rubienr/coax-relay-switch-shortwave/README.md

Shortwave Coax Switch for Antennas
__________________________________
* Very simple schema that switches up to four antenna relays.
* Needs poer just for switching process, remains without during radio operation.
* Up to 1.5KW with GUNNER 18V bistabile 25A AC relay.

Example
_______
The system contains of 4 PCBs:

* The input switch box:
  * 1x switch-matrix (ensures only one relay being active)
  * 1x relais-with-led-indicator (keeps the state, has LED indicator)

* The antenna switch box:
  * 1x switch-matrix (ensures only one relay being active)
  * 1x relais-with-led-indicator (keeps the state, LEDs optional)

Schema and PCB
______________
* Schemas
  * [switch-matrix](https://github.com/rubienr/coax-relay-switch-shortwave/blob/master/docs/switch-matrix-schema.pdf)
  * [relais-with-led-indicator](https://github.com/rubienr/coax-relay-switch-shortwave/blob/master/docs/led-indicator-schema.pdf)
* PCBs
  * [switch-matrix](https://github.com/rubienr/coax-relay-switch-shortwave/blob/master/docs/switch-matrix-pcb.pdf)
  * [relais-with-led-indicator](https://github.com/rubienr/coax-relay-switch-shortwave/blob/master/docs/relais-pcb.pdf)

Pictures
________
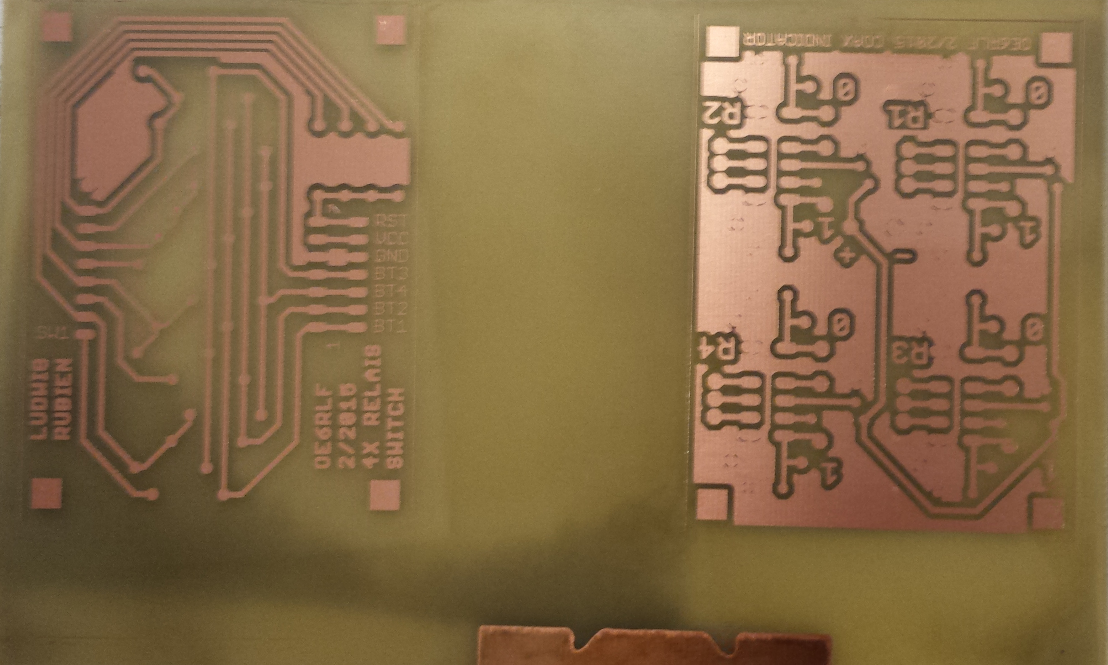
[picture p1: docs/pics/pcb-example.jpg]
bare PCB

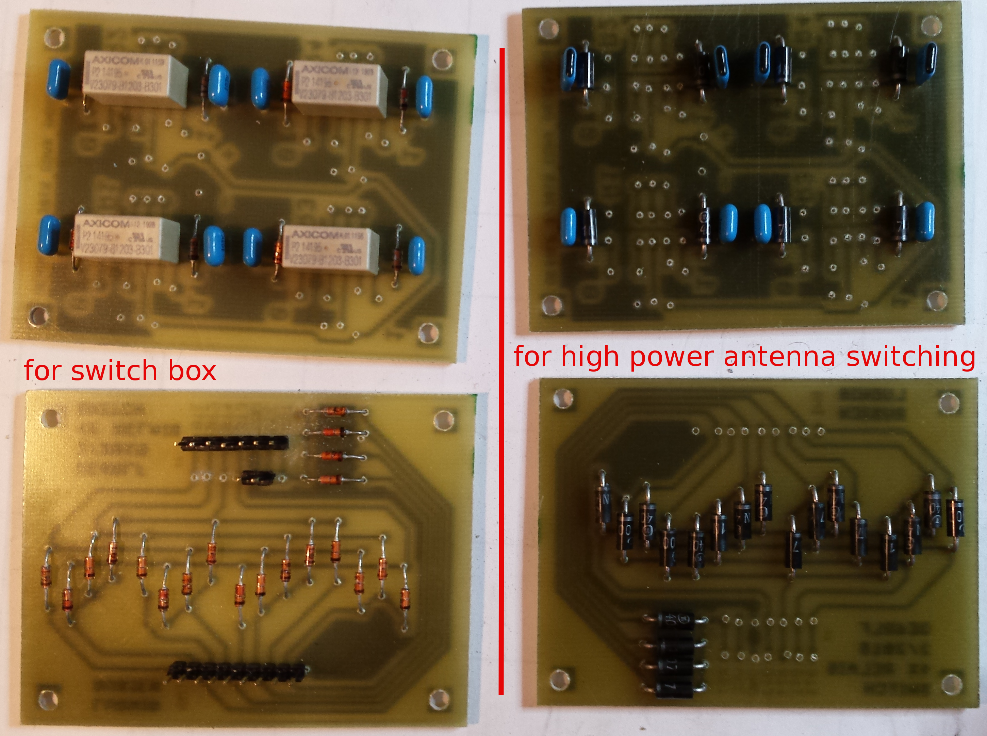
[picture p2: docs/pics/pcb-example-2.jpg]
assembled PCBs

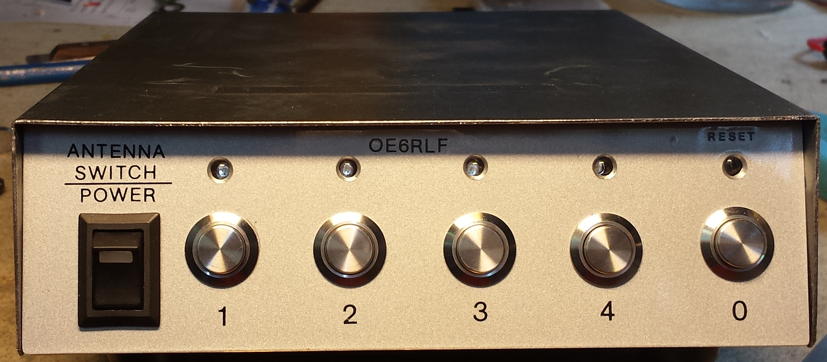
[picture p3: docs/pics/switch-box.jpg]
switch box/pannel

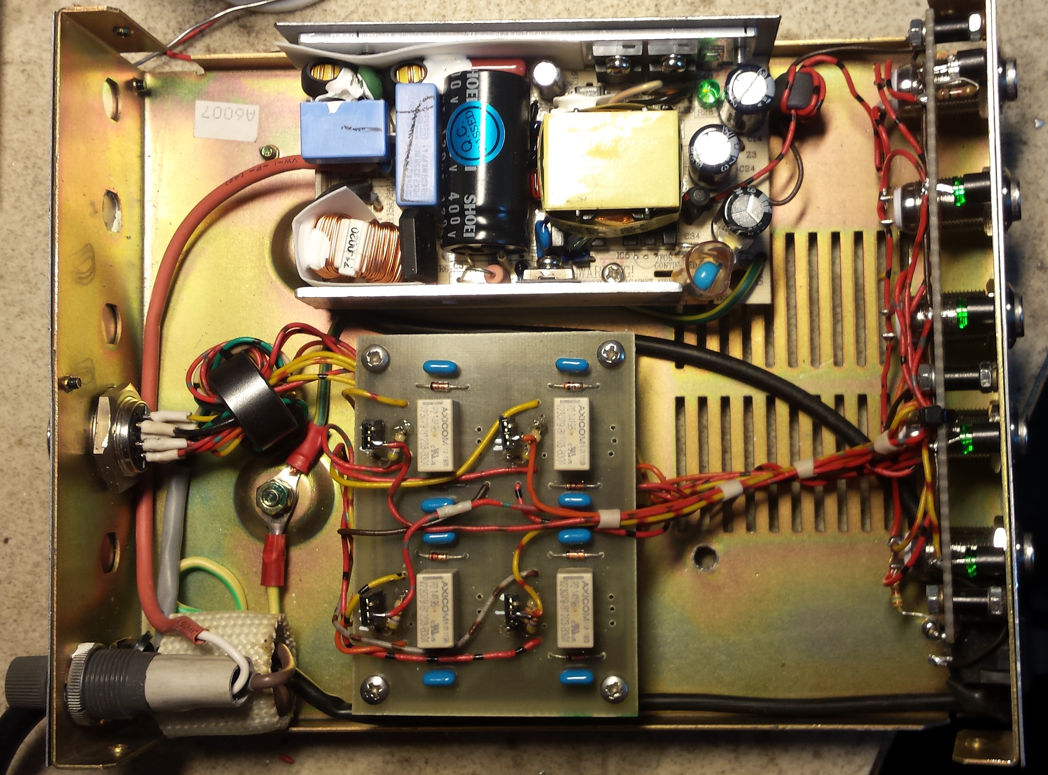
[picture p4: docs/pics/switch-box-interna.jpg]
switch box/pannel interna

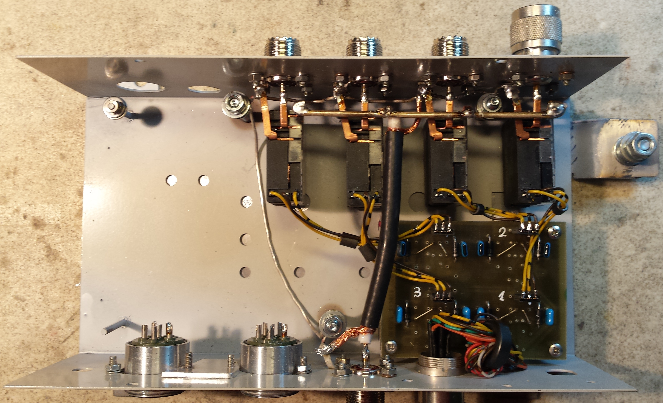
[picture p5: docs/pics/switch-matrix-with-relais-stacked-for-antenna-output.jpg]
antenna swtich box with stacked PCBs and high power relais
