rubienr/coax-relay-switch-shortwave/docs/led-indicator-schema.pdf

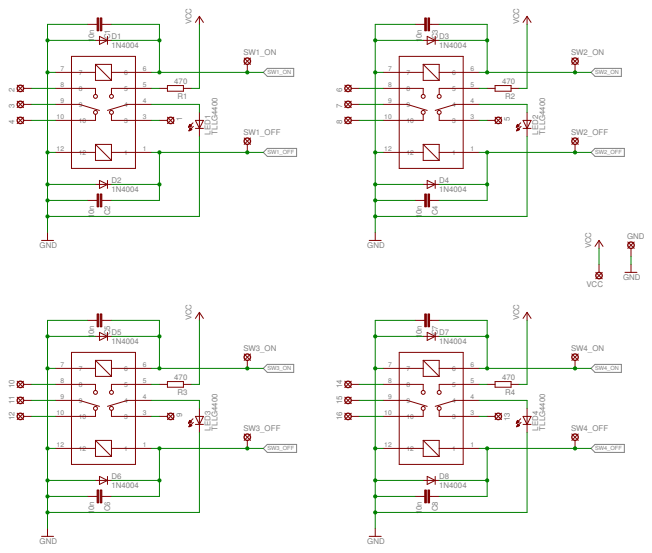
[picture p6: page 1]

TLLG4400 VCC 470 10n 1N4004 1N4004 10n GND GND VCC TLLG4400 VCC 470 10n 1N4004 1N4004 10n GND TLLG4400 VCC 470 10n 1N4004 1N4004 10n GND TLLG4400 VCC 470 10n 1N4004 1N4004 10n GND LED1 1 1 3 3 4 4 5 5 6 6 7 7 8 8 9 9 10 10 12 12 R1 C1D1 D2 C2 1 2 3 4 SW1_ON SW1_OFF VCC GND LED2 1 1 3 3 4 4 5 5 6 6 7 7 8 8 9 9 10 10 12 12 R2 C3D3 D4 C4 5 6 7 8 SW2_ON SW2_OFF LED3 1 1 3 3 4 4 5 5 6 6 7 7 8 8 9 9 10 10 12 12 R3 C5D5 D6 C6 9 10 11 12 SW3_ON SW3_OFF LED4 1 1 3 3 4 4 5 5 6 6 7 7 8 8 9 9 10 10 12 12 R4 C7D7 D8 C8 13 14 15 16 SW4_ON SW4_OFF SW1_ON SW1_OFF SW2_ON SW2_OFF SW3_ON SW3_OFF SW4_ON SW4_OFF
