rubienr/coax-relay-switch-shortwave/docs/relais-pcb.pdf

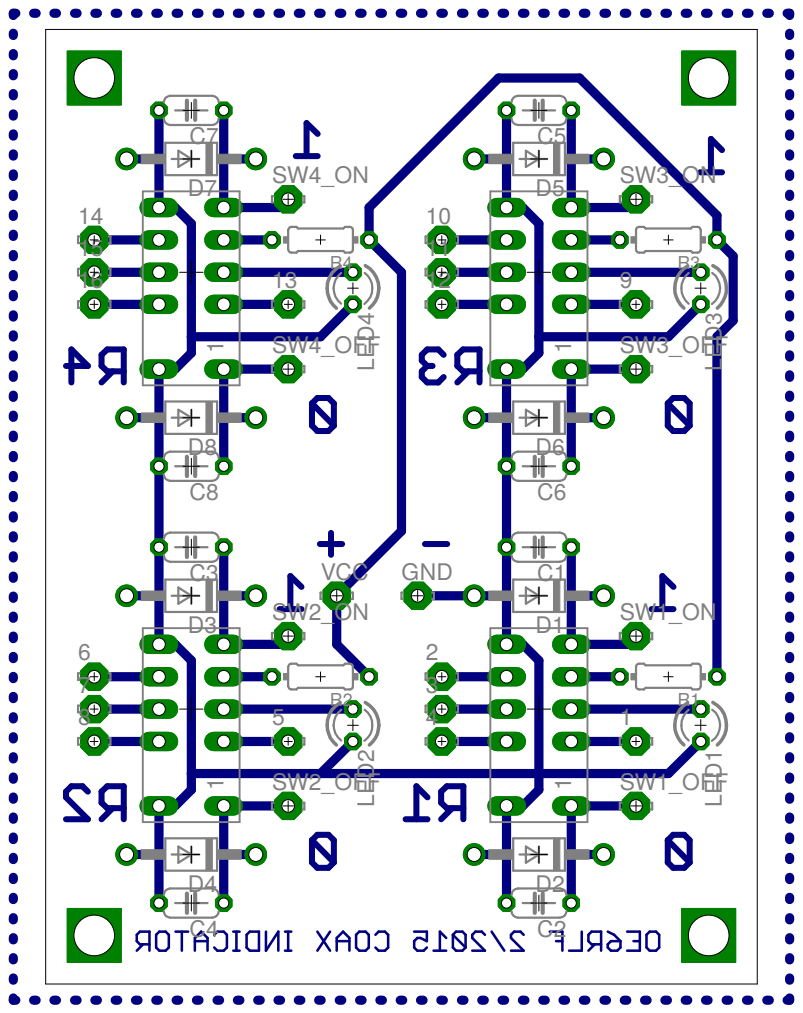
[picture p7: page 1]
