rubienr/coax-relay-switch-shortwave/docs/switch-matrix-pcb.pdf

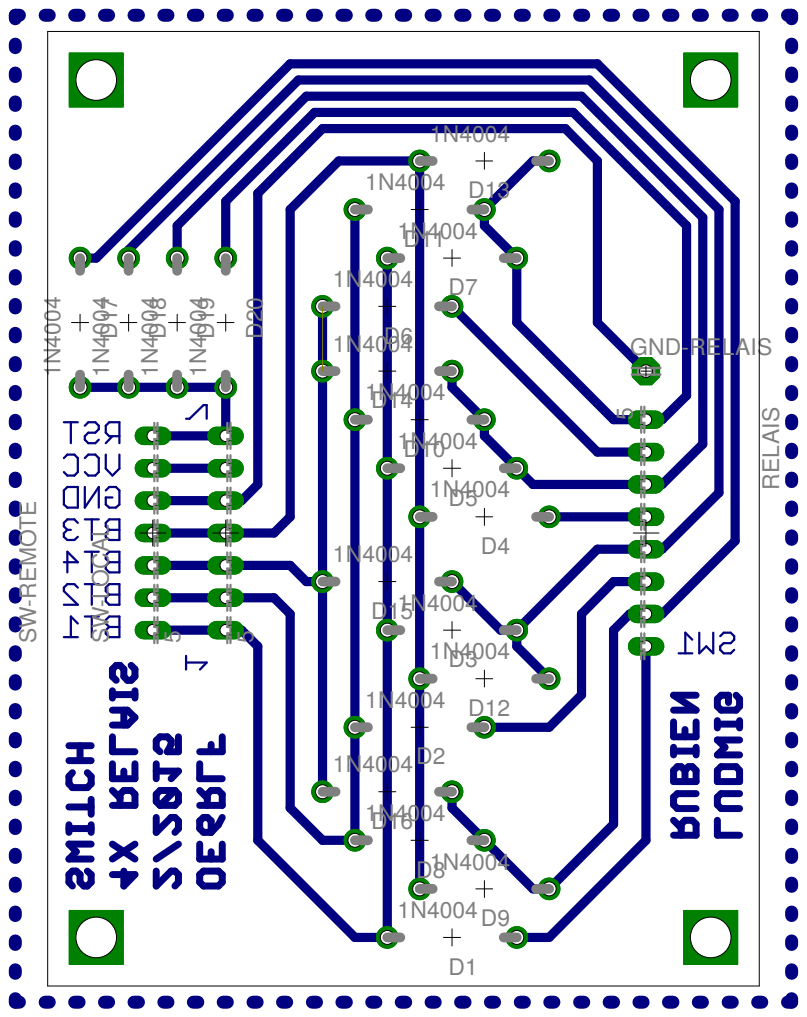
[picture p8: page 1]
