rubienr/coax-relay-switch-shortwave/docs/switch-matrix-schema.pdf

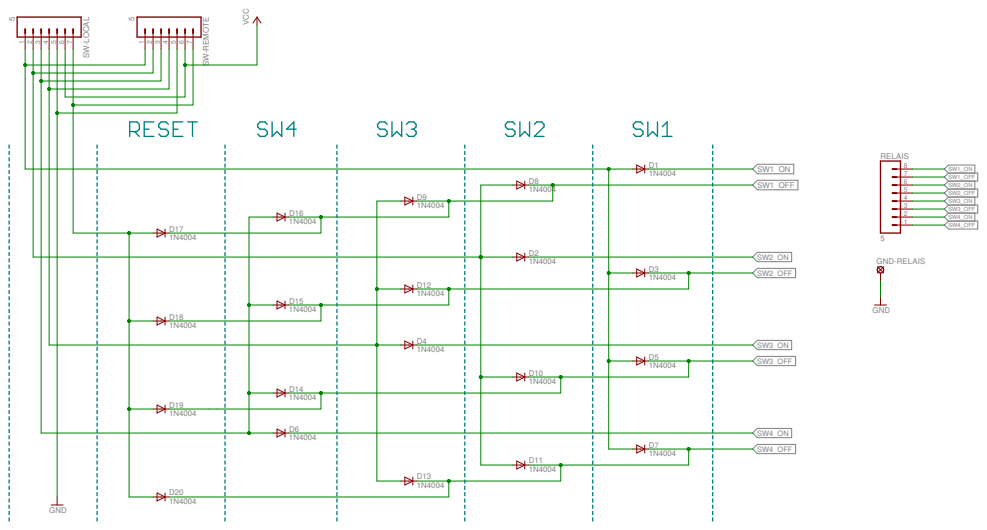
[picture p9: page 1]
