rubienr/coax-relay-switch-shortwave/eagle/relais-with-led-indicator.brd

## EAGLE design eagle/relais-with-led-indicator.brd (2016-01-24)

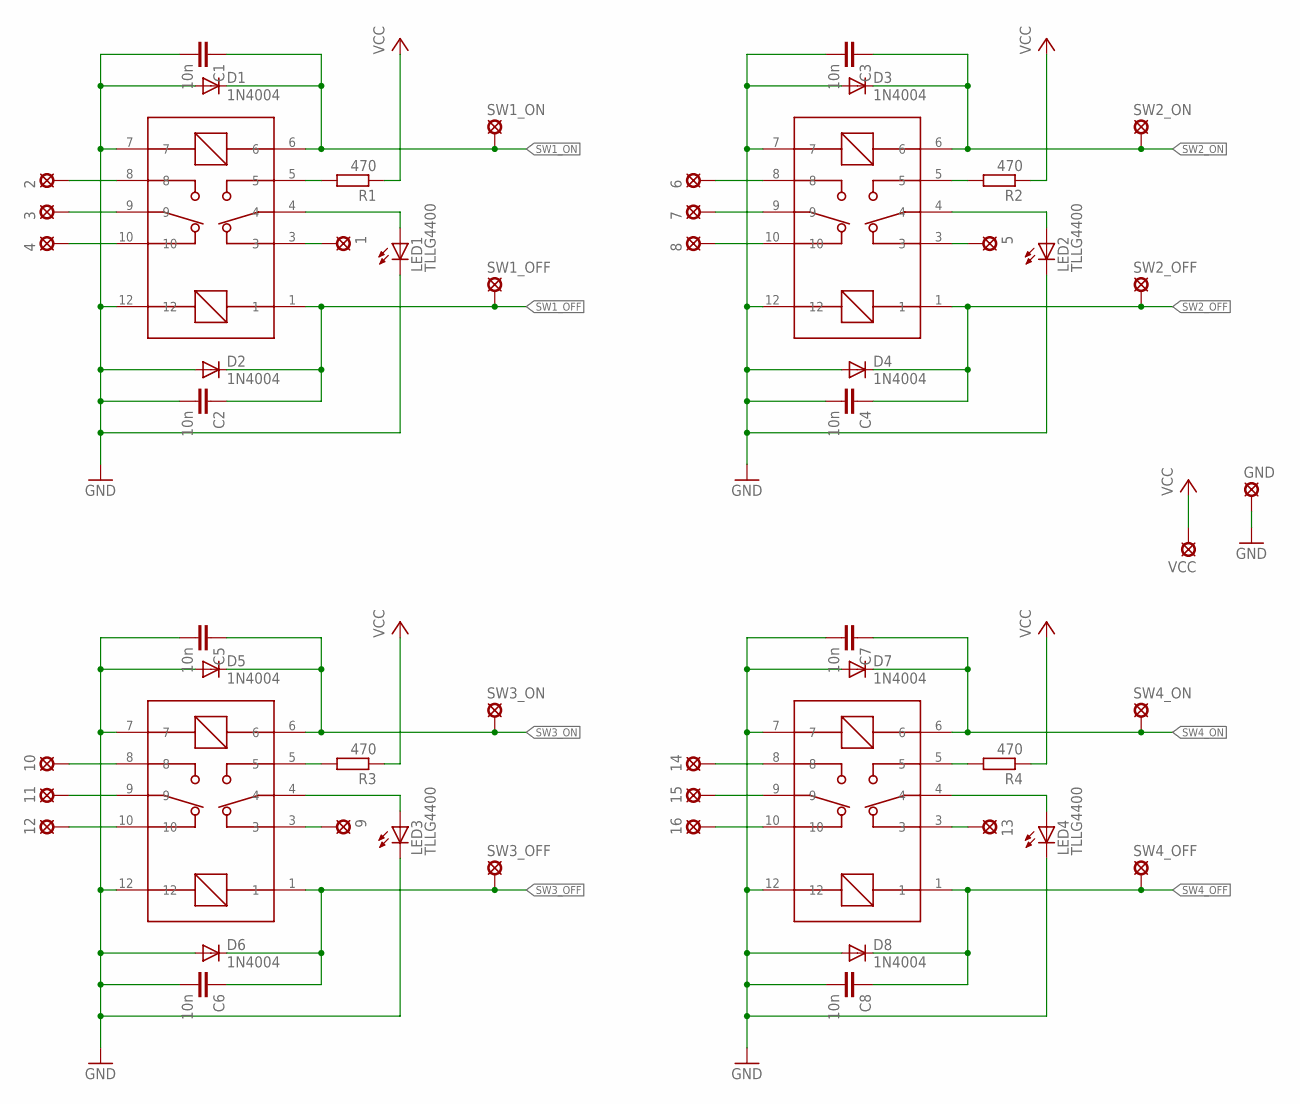
[picture p10: schematic relais-with-led-indicator.sch]

Parts:
1, 2, 3, 4, 5, 6, 7, 8, 9, 10, 11, 12, 13, 14, 15, 16: LSP10
C1, C2, C3, C4, C5, C6, C7, C8: 10n; C050-024X044
D1, D2, D3, D4, D5, D6, D7, D8: 1N4004; DO41-10
GND: LSP10
LED1, LED2, LED3, LED4: TLLG4400; LED3MM
R1, R2, R3, R4: 470; 0204/7
RL1, RL2, RL3, RL4: BISTABIL-2-COILS; BISTABILE-2-COILS
SW1_OFF, SW1_ON, SW2_OFF, SW2_ON, SW3_OFF, SW3_ON, SW4_OFF, SW4_ON: LSP10
VCC: LSP10

Connections:
GND: C1.2, C2.2, C3.2, C4.2, C5.2, C6.2, C7.2, C8.2, D1.A, D2.A, D3.A, D4.A, D5.A, D6.A, D7.A, D8.A, GND.MP, LED1.K (C), LED2.K (C), LED3.K (C), LED4.K (C), RL1.7, RL1.12, RL2.7, RL2.12, RL3.7, RL3.12, RL4.7, RL4.12
unnamed: LED1.A, RL1.4
unnamed: LED2.A, RL2.4
unnamed: 4.MP, RL1.10
unnamed: R2.2, RL2.5
unnamed: R1.2, RL1.5
unnamed: 8.MP, RL2.10
unnamed: 7.MP, RL2.9
unnamed: 6.MP, RL2.8
unnamed: 5.MP, RL2.3
unnamed: LED3.A, RL3.4
unnamed: 3.MP, RL1.9
unnamed: 2.MP, RL1.8
unnamed: 1.MP, RL1.3
unnamed: R3.2, RL3.5
unnamed: 12.MP, RL3.10
unnamed: 11.MP, RL3.9
unnamed: 10.MP, RL3.8
unnamed: 9.MP, RL3.3
unnamed: LED4.A, RL4.4
unnamed: R4.2, RL4.5
unnamed: 16.MP, RL4.10
unnamed: 15.MP, RL4.9
unnamed: 14.MP, RL4.8
unnamed: 13.MP, RL4.3
SW1_OFF: C2.1, D2.C, RL1.1, SW1_OFF.MP
SW1_ON: C1.1, D1.C, RL1.6, SW1_ON.MP
SW2_OFF: C4.1, D4.C, RL2.1, SW2_OFF.MP
SW2_ON: C3.1, D3.C, RL2.6, SW2_ON.MP
SW3_OFF: C6.1, D6.C, RL3.1, SW3_OFF.MP
SW3_ON: C5.1, D5.C, RL3.6, SW3_ON.MP
SW4_OFF: C8.1, D8.C, RL4.1, SW4_OFF.MP
SW4_ON: C7.1, D7.C, RL4.6, SW4_ON.MP
VCC: R1.1, R2.1, R3.1, R4.1, VCC.MP

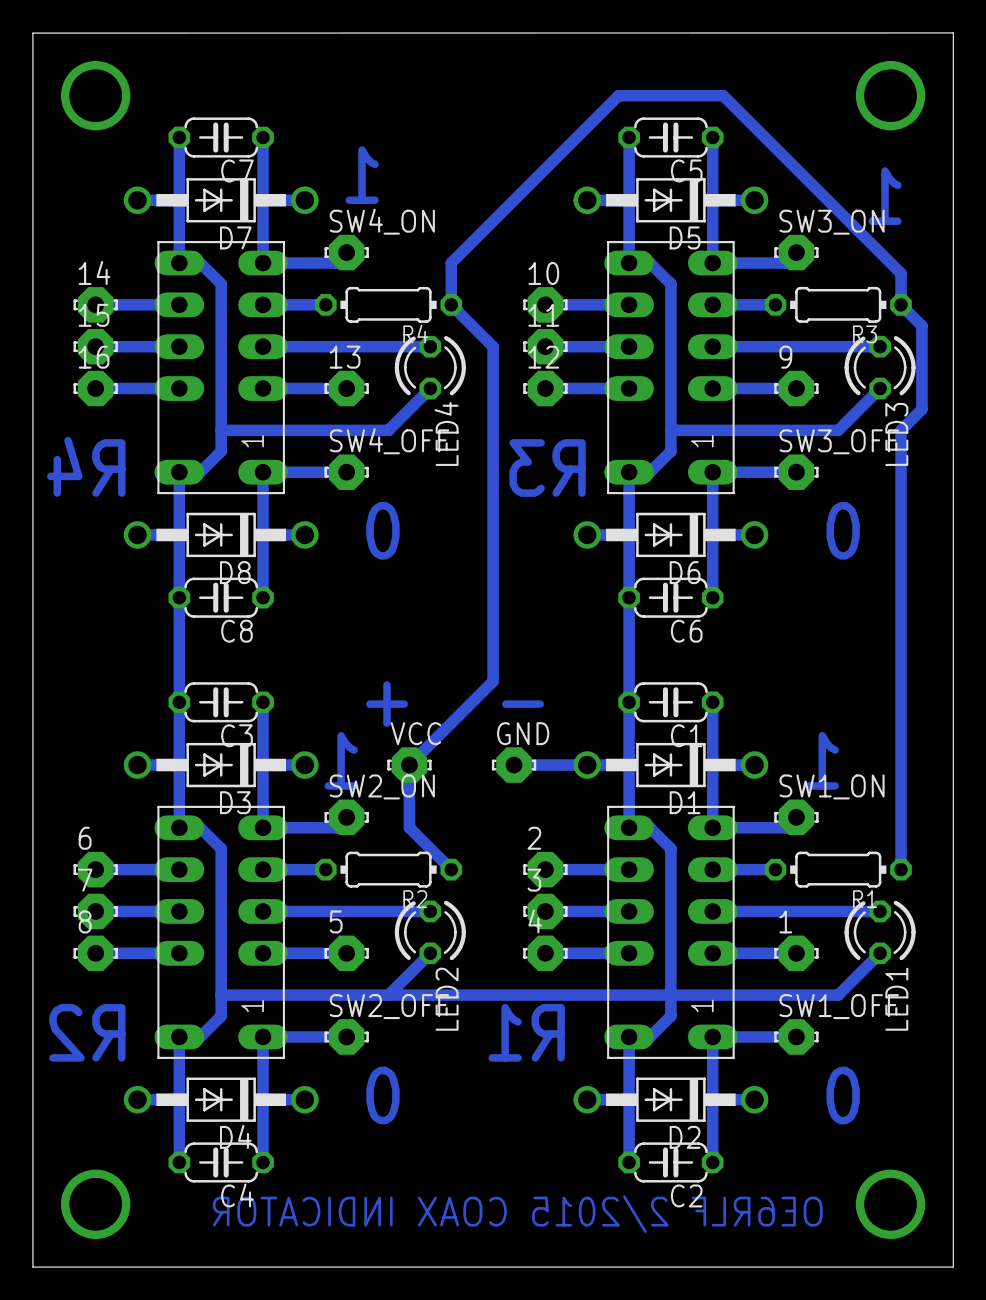
[picture p11: board relais-with-led-indicator.brd from above]

Board: 2 copper layers, 55.9 x 74.9 mm, 54 parts (0 on the bottom side), 34 nets.
