rubienr/coax-relay-switch-shortwave/eagle/switch-matrix.brd

## EAGLE design eagle/switch-matrix.brd (2016-01-24)

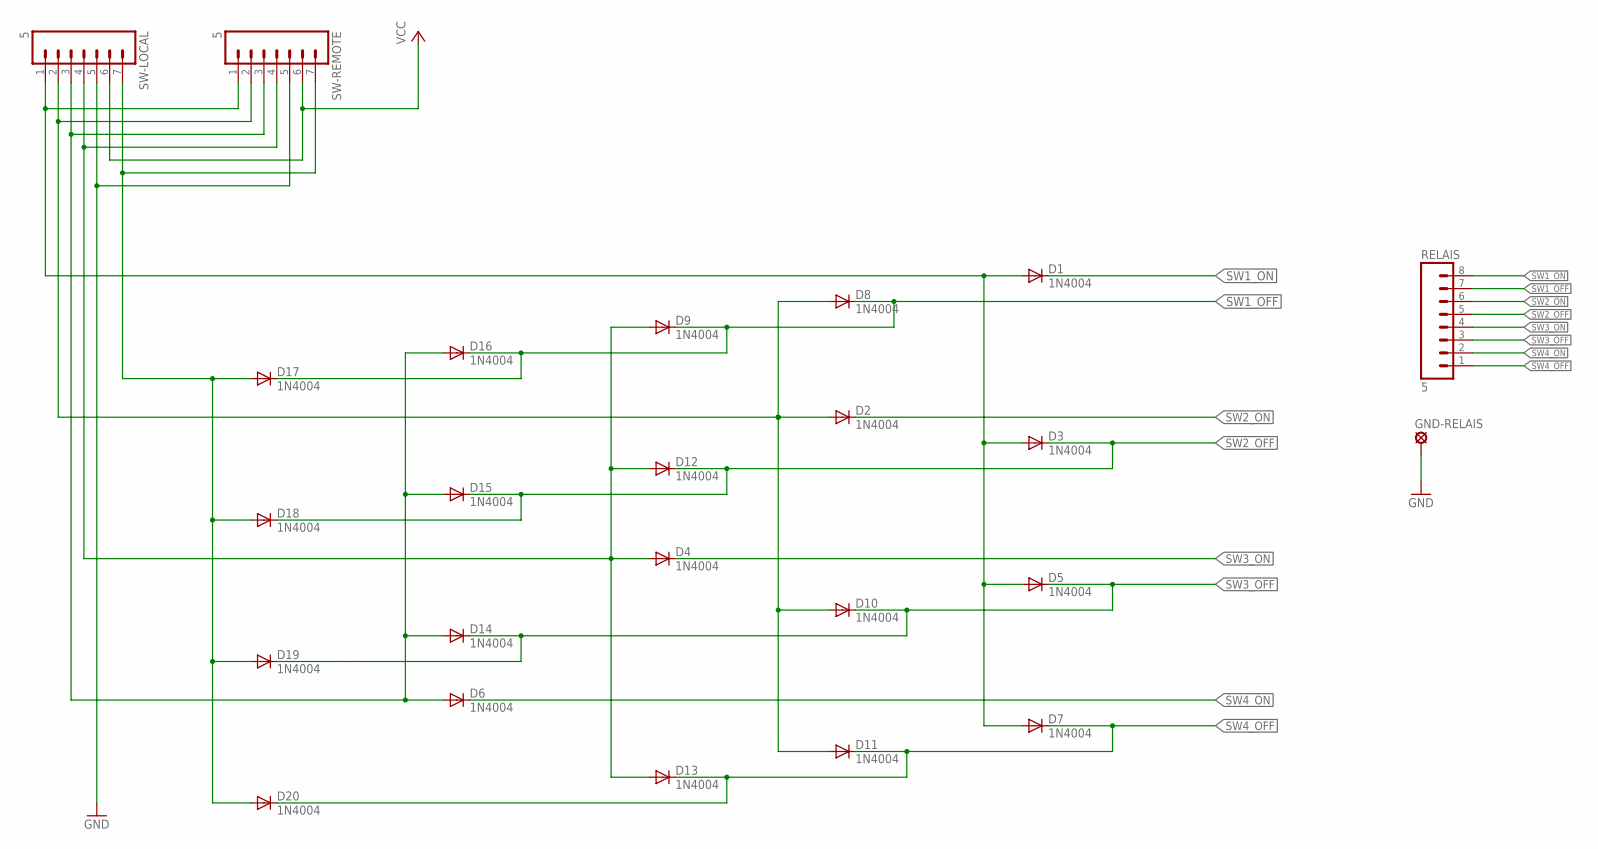
[picture p12: schematic switch-matrix.sch]

Parts:
D1, D2, D3, D4, D5, D6, D7, D8, D9, D10, D11, D12, D13, D14, D15, D16, D17, D18, D19, D20: 1N4004; DO41-10
GND-RELAIS: LSP10
RELAIS: 5; 08PA
SW-LOCAL: 5; 07PA
SW-REMOTE: 5; 07PA

Connections:
GND: GND-RELAIS.MP, SW-LOCAL.5, SW-REMOTE.5
unnamed: D1.A, D3.A, D5.A, D7.A, SW-LOCAL.1, SW-REMOTE.1
unnamed: D17.A, D18.A, D19.A, D20.A, SW-LOCAL.7, SW-REMOTE.7
unnamed: D4.A, D9.A, D12.A, D13.A, SW-LOCAL.4, SW-REMOTE.4
unnamed: D6.A, D14.A, D15.A, D16.A, SW-LOCAL.3, SW-REMOTE.3
unnamed: D2.A, D8.A, D10.A, D11.A, SW-LOCAL.2, SW-REMOTE.2
SW1_OFF: D8.C, D9.C, D16.C, D17.C, RELAIS.7
SW1_ON: D1.C, RELAIS.8
SW2_OFF: D3.C, D12.C, D15.C, D18.C, RELAIS.5
SW2_ON: D2.C, RELAIS.6
SW3_OFF: D5.C, D10.C, D14.C, D19.C, RELAIS.3
SW3_ON: D4.C, RELAIS.4
SW4_OFF: D7.C, D11.C, D13.C, D20.C, RELAIS.1
SW4_ON: D6.C, RELAIS.2
VCC: SW-LOCAL.6, SW-REMOTE.6

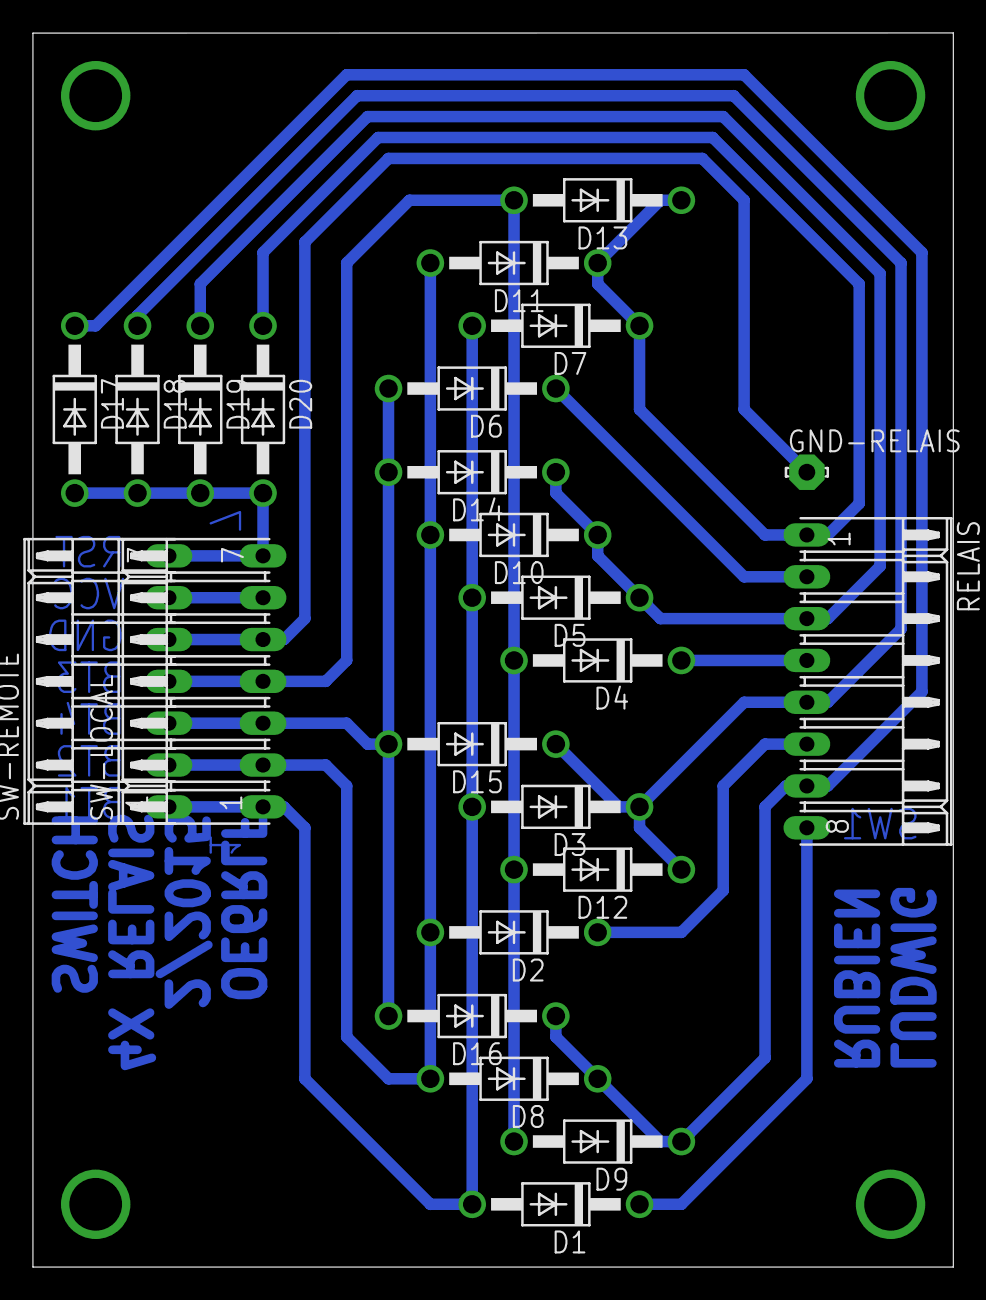
[picture p13: board switch-matrix.brd from above]

Board: 2 copper layers, 55.9 x 74.9 mm, 24 parts (0 on the bottom side), 15 nets.
